mfulz/cyberpunk-elevated-district/images/README.md

# Image and video gallery

All publication media in this directory has been copied from the build archive,
resized where appropriate and stripped of EXIF metadata. The original files in
`screens/` remain untouched.

The collection is intentionally generous for the pre-publication review. Delete
any view that should not be public, then remove its link from this file and run
`python3 tools/update_checksums.py` followed by `python3 tools/verify_release.py`.

## Finished district

### Night views

Main night view

*Main release image: completed elevated district with the stair runner crossing
its red/purple phase.*

<table>
  <tr>
    <td>Blue night overview</td>
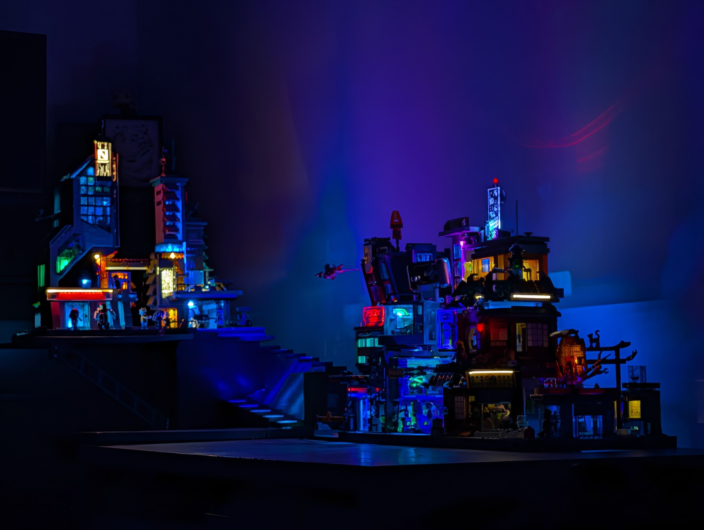
[picture p4: images/final/overview-night-cyan.jpg]
Cyan night overview
    <td></td>
  </tr>
  <tr>
    <td align="center"><em>Blue/purple phase</em></td>
    <td align="center"><em>Cyan/blue phase</em></td>
  </tr>
</table>

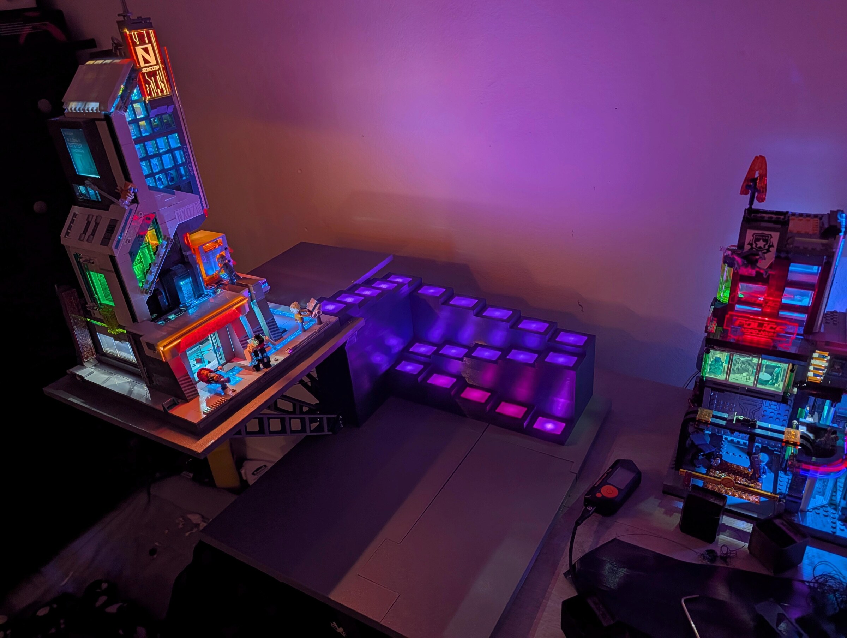
[picture p5: images/final/pre-techstation-night.jpg]
Earlier night arrangement before Tech Station


*Earlier night arrangement, useful for separating the printed structure from the
later fifth building.*

### Daylight and scale

<table>
  <tr>
    <td>Wide daylight overview</td>
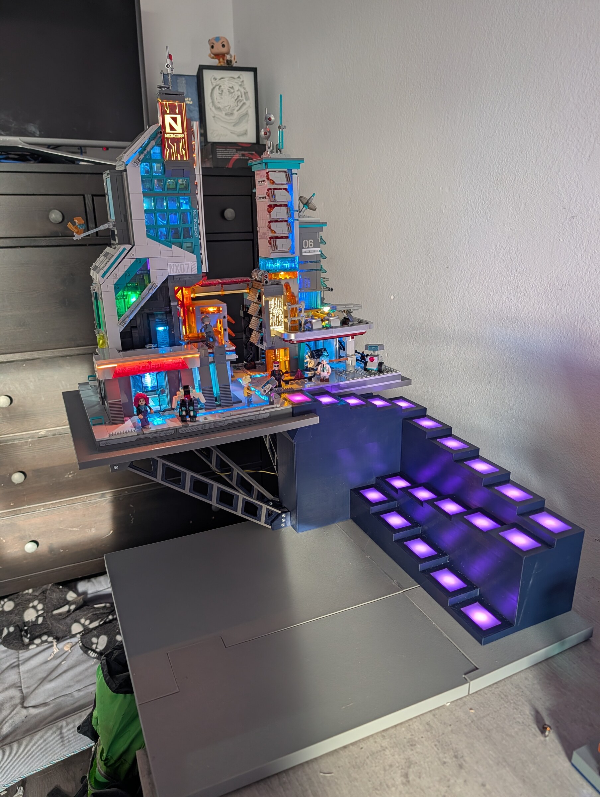
[picture p6: images/final/elevated-district-day.jpg]
Elevated district close daylight view
    <td></td>
  </tr>
  <tr>
    <td align="center"><em>Complete table and overhang</em></td>
    <td align="center"><em>Upper district, trusses and stairs</em></td>
  </tr>
  <tr>
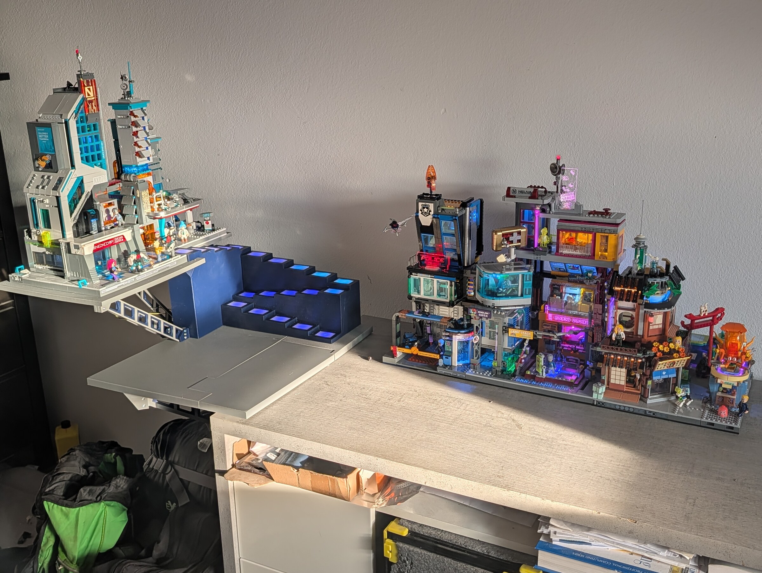
[picture p7: images/final/full-desk-day.jpg]
Full desk daylight view
    <td></td>
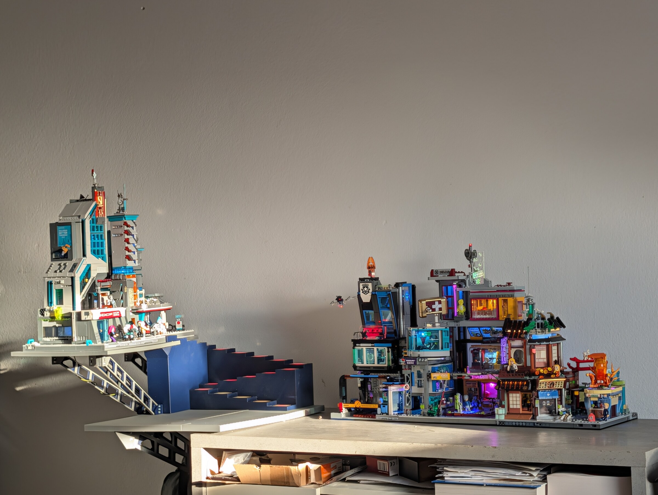
[picture p8: images/final/side-profile-day.jpg]
Side profile daylight view
    <td></td>
  </tr>
  <tr>
    <td align="center"><em>Normal room-scale view</em></td>
    <td align="center"><em>Side profile and visible cantilever</em></td>
  </tr>
</table>

## Construction sequence

### CAD and cable concept

<table>
  <tr>
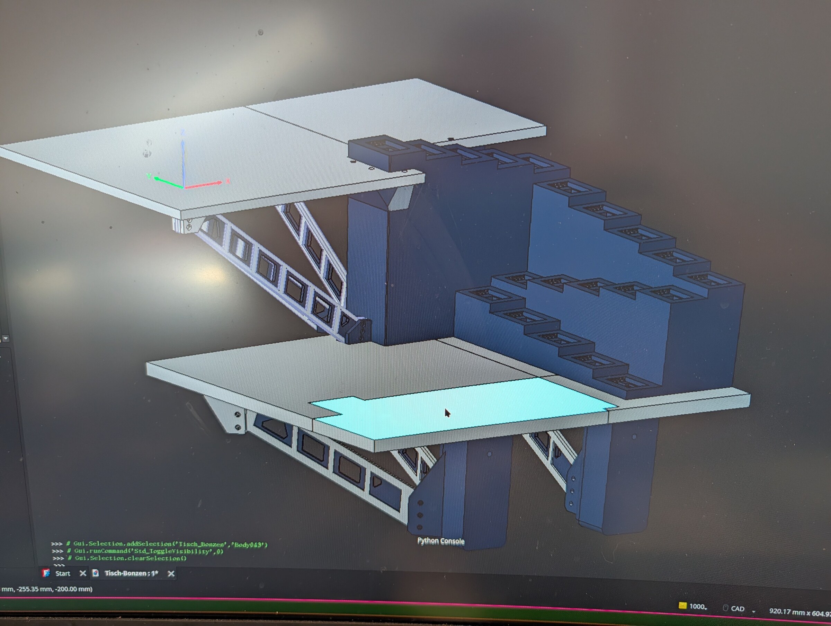
[picture p9: images/build/cad-complete.jpg]
Complete CAD structure
    <td></td>
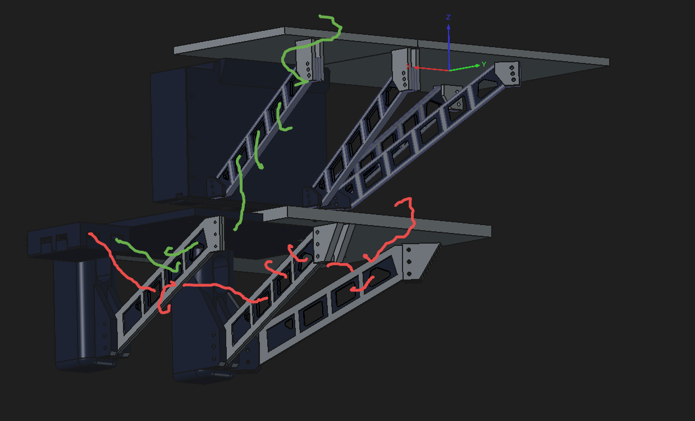
[picture p10: images/build/cad-cable-routing.png]
CAD cable-routing sketch
    <td></td>
  </tr>
  <tr>
    <td align="center"><em>Complete positioned structure</em></td>
    <td align="center"><em>Early exposed-cable routing concept</em></td>
  </tr>
</table>

### NeoPixel staircase development

<table>
  <tr>
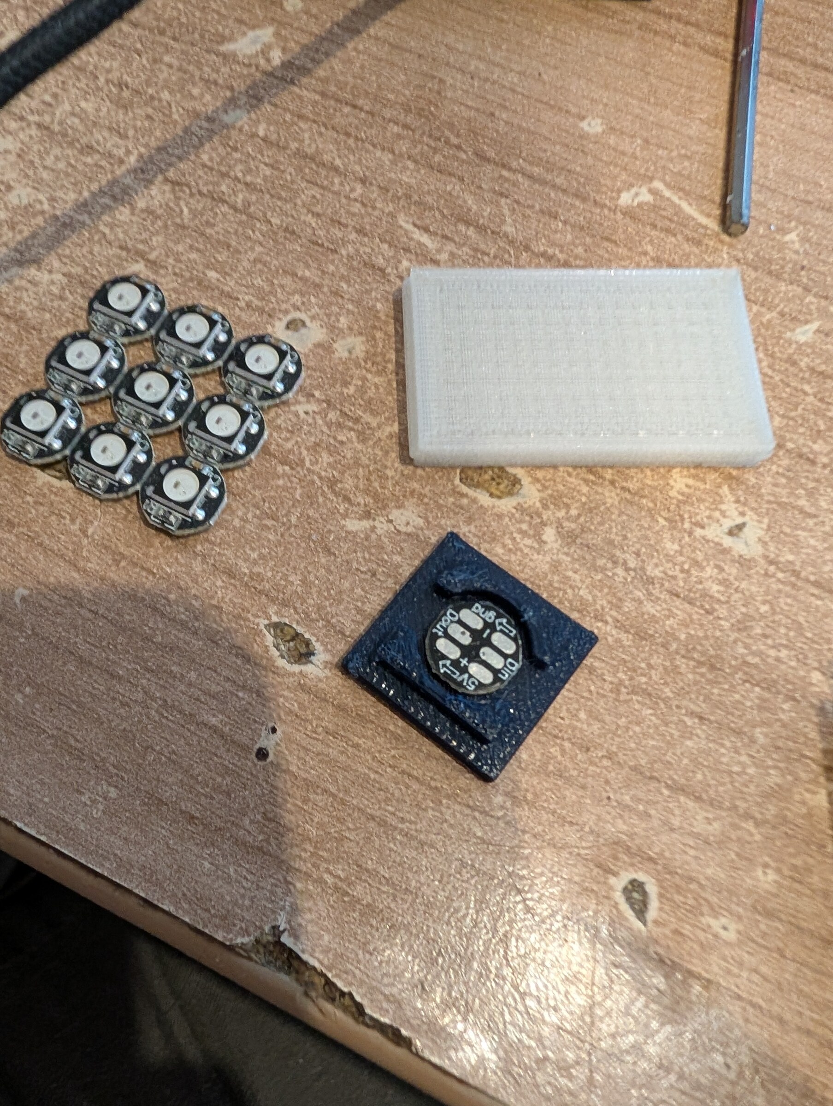
[picture p11: images/build/neopixel-diffuser-test.jpg]
NeoPixel carrier and diffuser test
    <td></td>
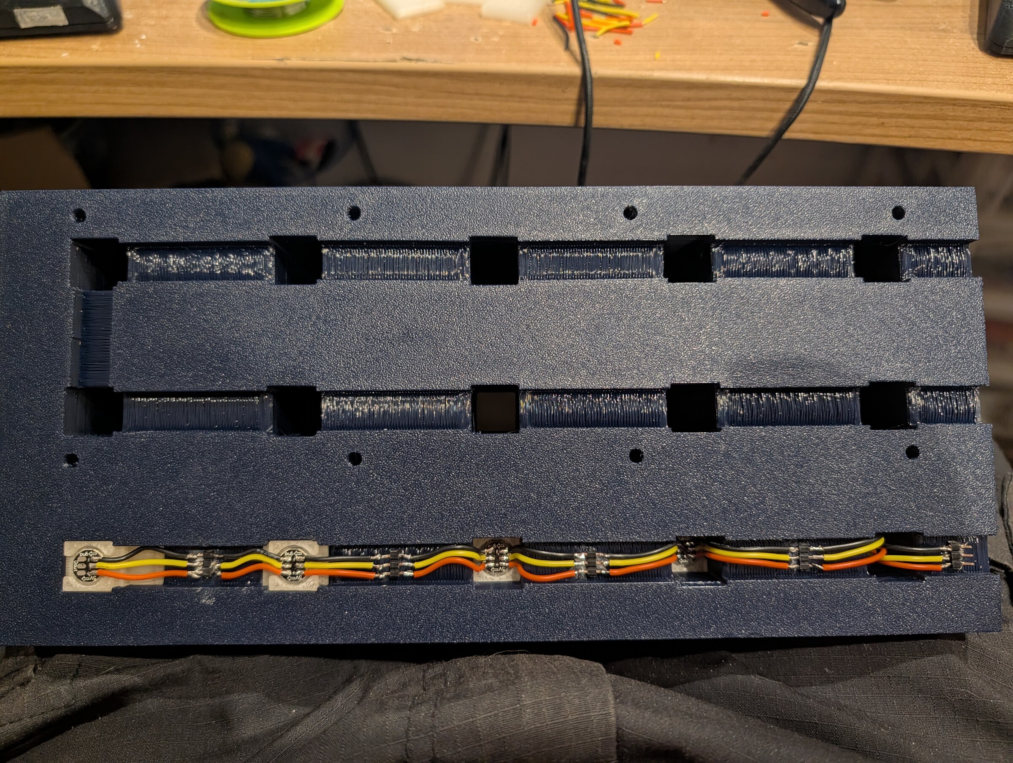
[picture p12: images/build/main-stair-led-chain.jpg]
Wired LED chain below the staircase
    <td></td>
  </tr>
  <tr>
    <td align="center"><em>Replaceable carrier and 100% infill diffuser test</em></td>
    <td align="center"><em>Five-pixel module wiring in its underside channel</em></td>
  </tr>
  <tr>
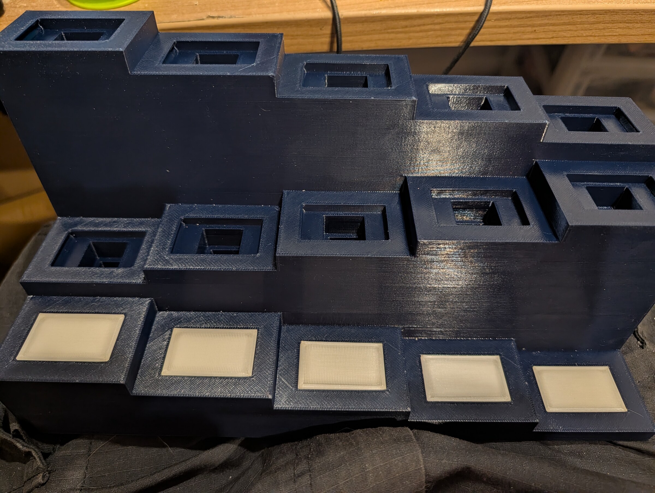
[picture p13: images/build/main-stair-assembled.jpg]
Assembled main staircase
    <td></td>
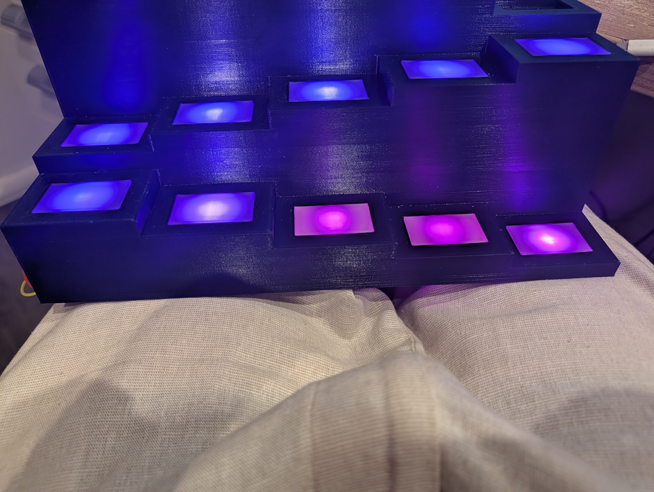
[picture p14: images/build/stair-light-test.jpg]
Illuminated staircase test
    <td></td>
  </tr>
  <tr>
    <td align="center"><em>Diffusers installed from above</em></td>
    <td align="center"><em>Ten-step animation and diffusion test</em></td>
  </tr>
</table>

### Controller and 5 V distribution

<table>
  <tr>
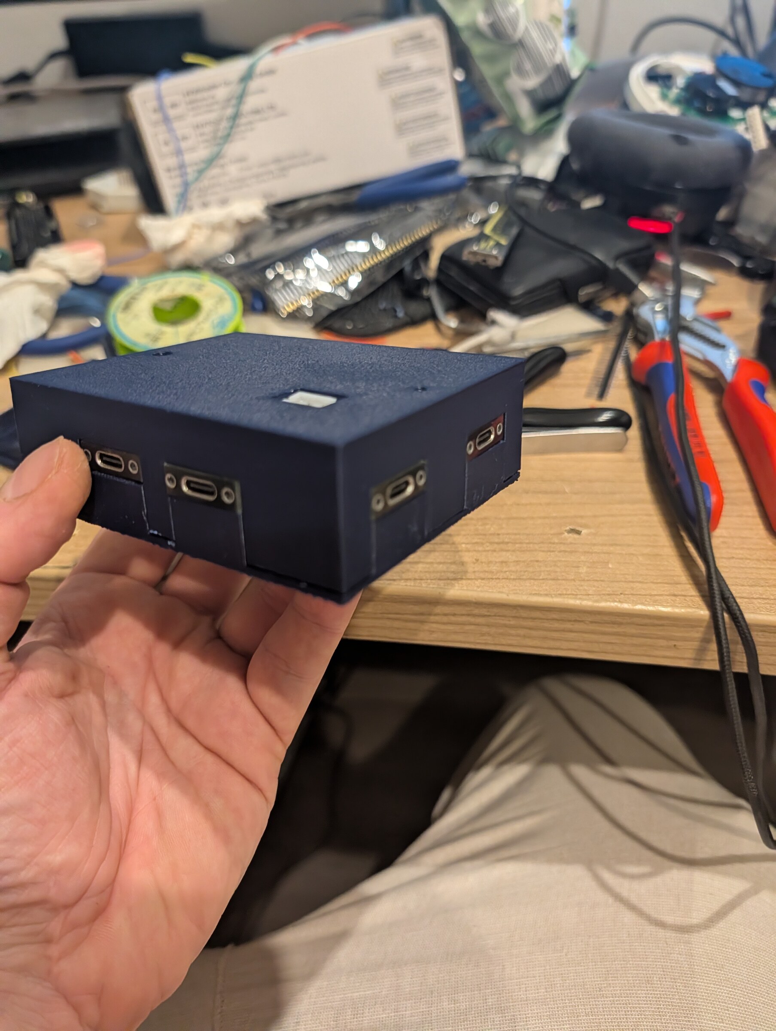
[picture p15: images/build/controller-enclosure-closed.jpg]
Closed controller enclosure
    <td></td>
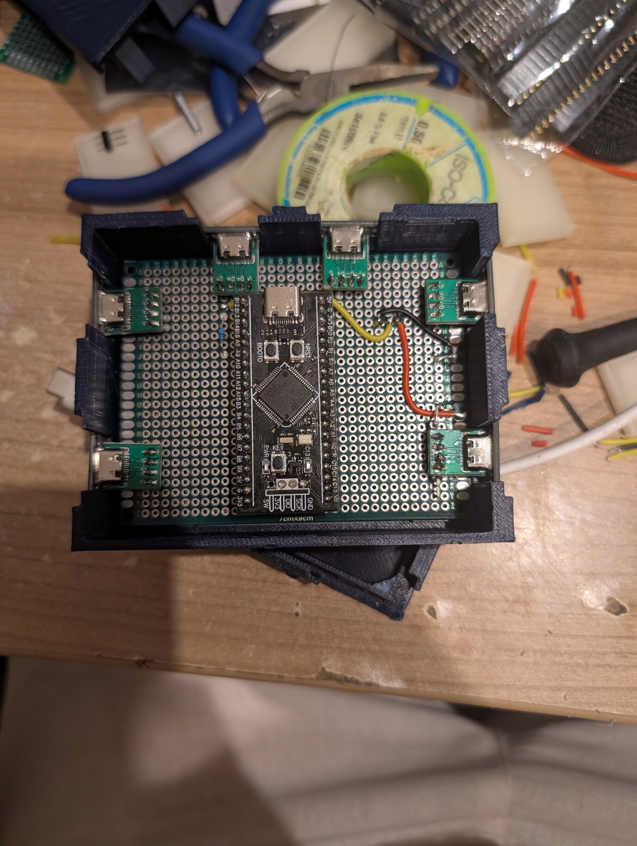
[picture p16: images/build/controller-enclosure-open-top.jpg]
Controller enclosure with open lid
    <td></td>
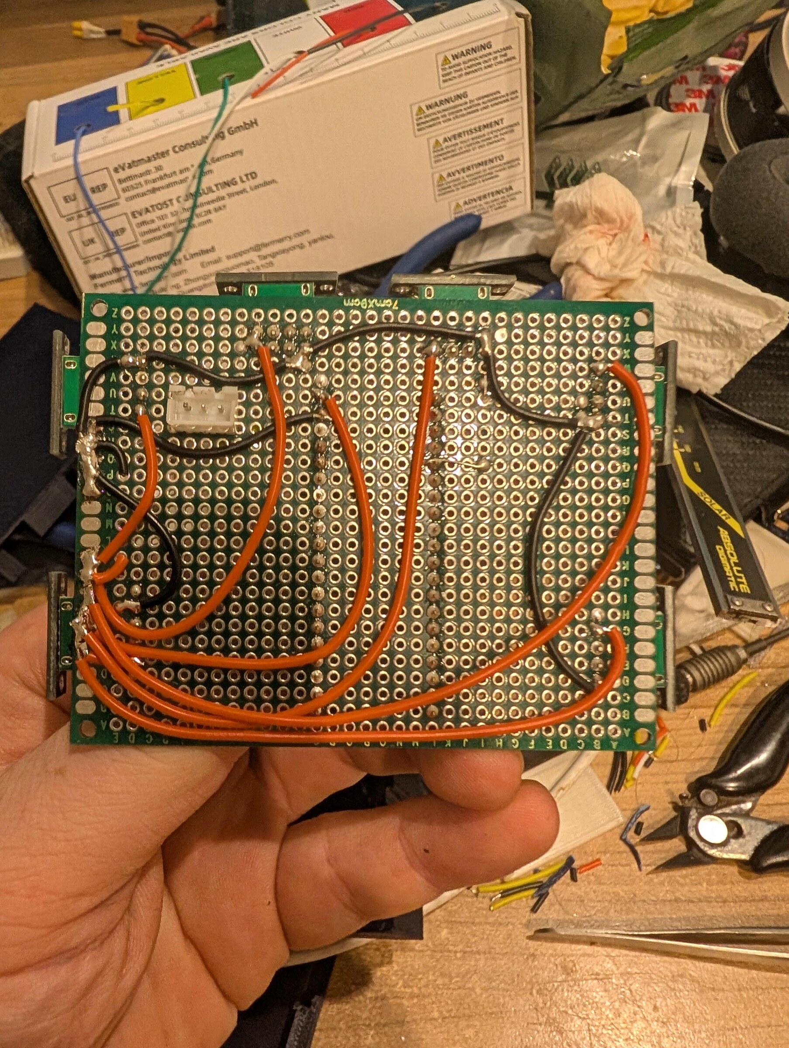
[picture p17: images/build/controller-perfboard-rear.jpg]
Rear of controller perfboard
    <td></td>
  </tr>
  <tr>
    <td align="center"><em>Five outputs plus one input</em></td>
    <td align="center"><em>BlackPill and reinforced star points</em></td>
    <td align="center"><em>Hand-wired perfboard underside</em></td>
  </tr>
</table>

### Structural assembly

<table>
  <tr>
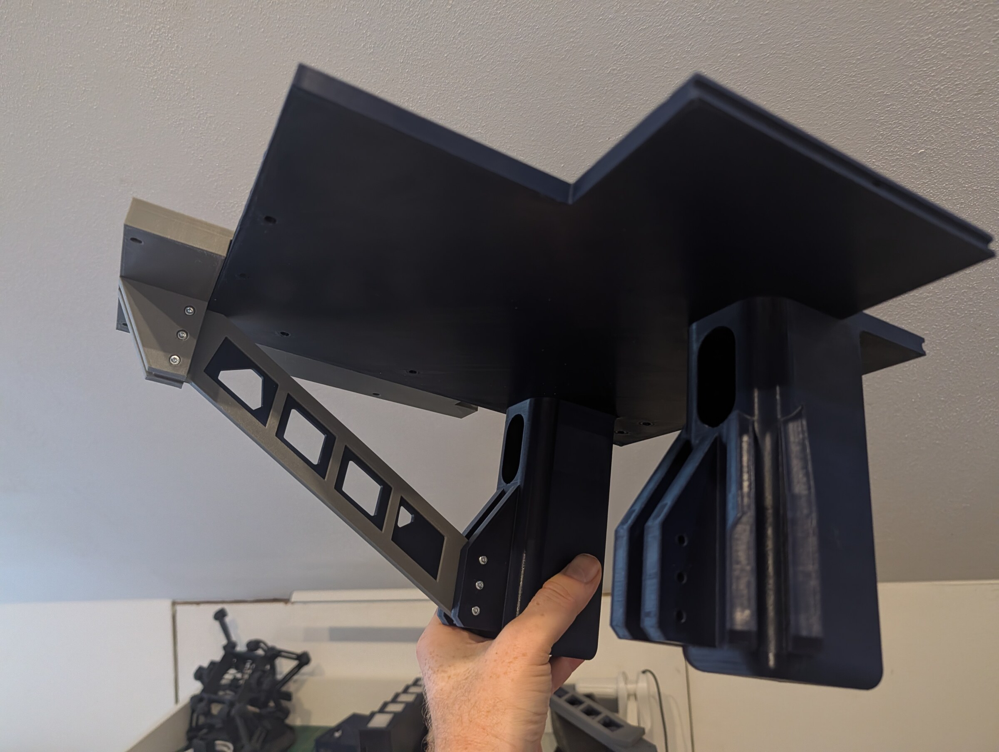
[picture p18: images/build/table-anchor-understructure.jpg]
Table anchor underside
    <td></td>
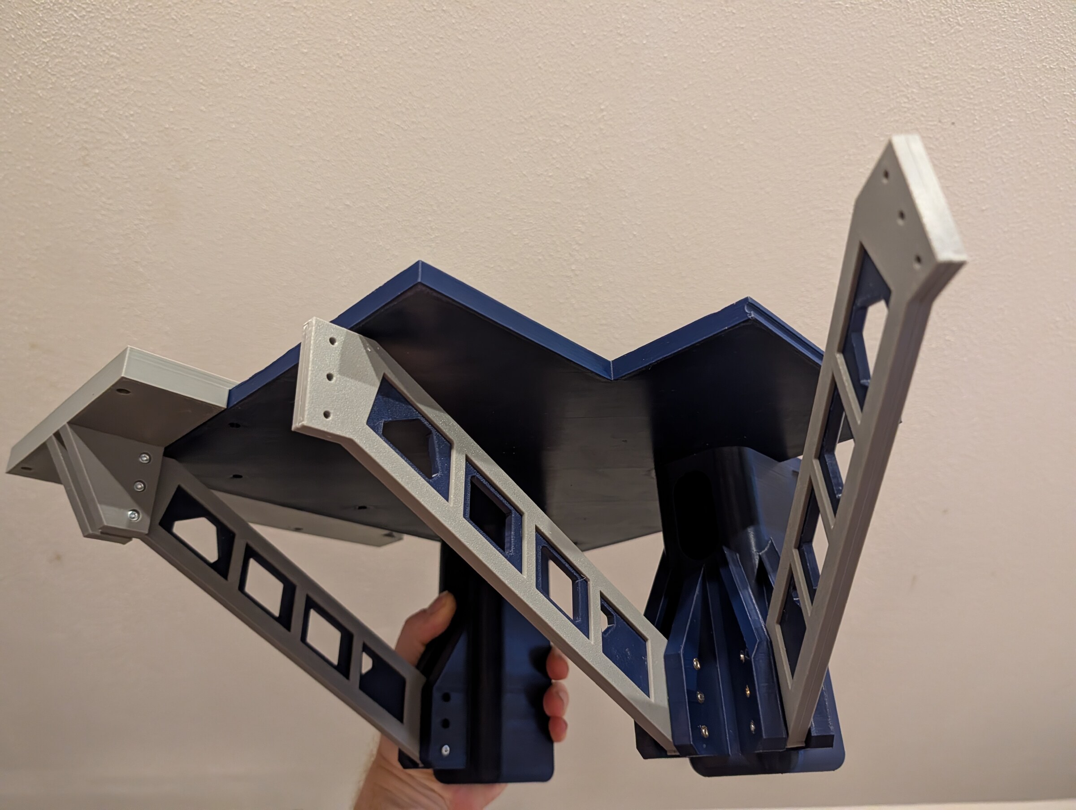
[picture p19: images/build/table-anchor-with-trusses.jpg]
Table anchor with laminated trusses
    <td></td>
  </tr>
  <tr>
    <td align="center"><em>Anchor, deck plates and interface blocks</em></td>
    <td align="center"><em>Laminated lower trusses before installation</em></td>
  </tr>
  <tr>
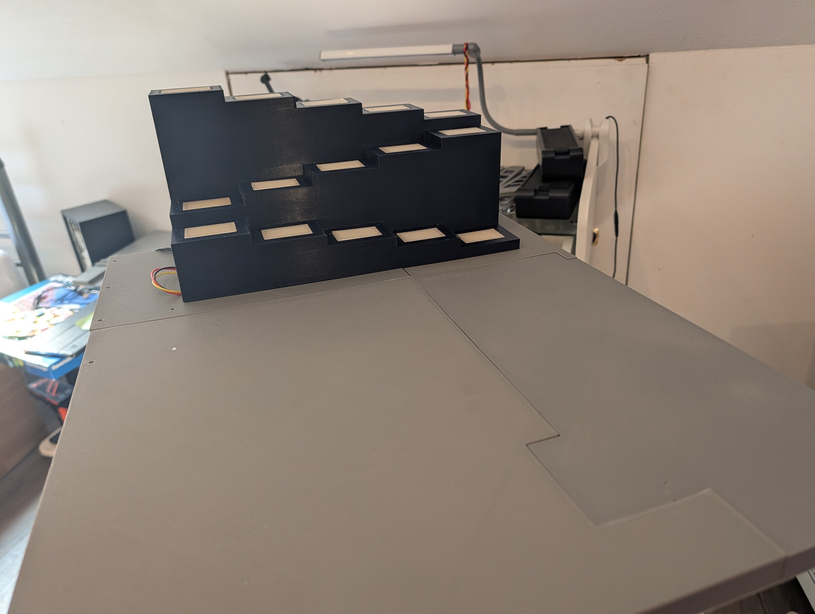
[picture p20: images/build/lower-deck-installed.jpg]
Lower deck installed on table
    <td></td>
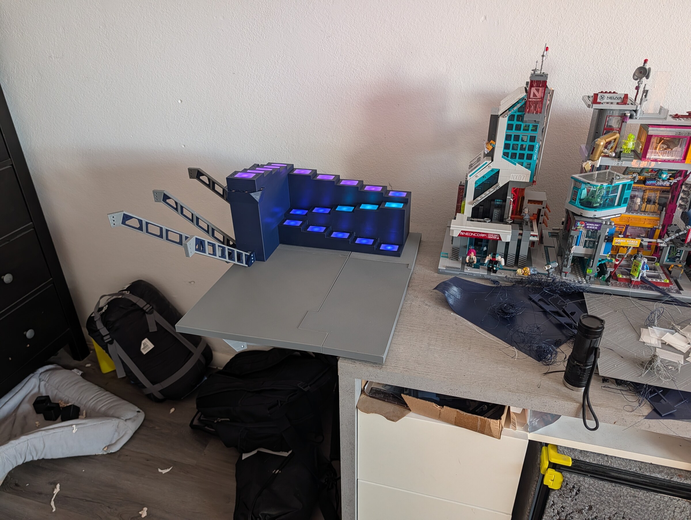
[picture p21: images/build/staircase-installation.jpg]
Staircase installation
    <td></td>
  </tr>
  <tr>
    <td align="center"><em>Lower deck and stair core mounted to the table</em></td>
    <td align="center"><em>Illuminated stair core before upper decks</em></td>
  </tr>
  <tr>
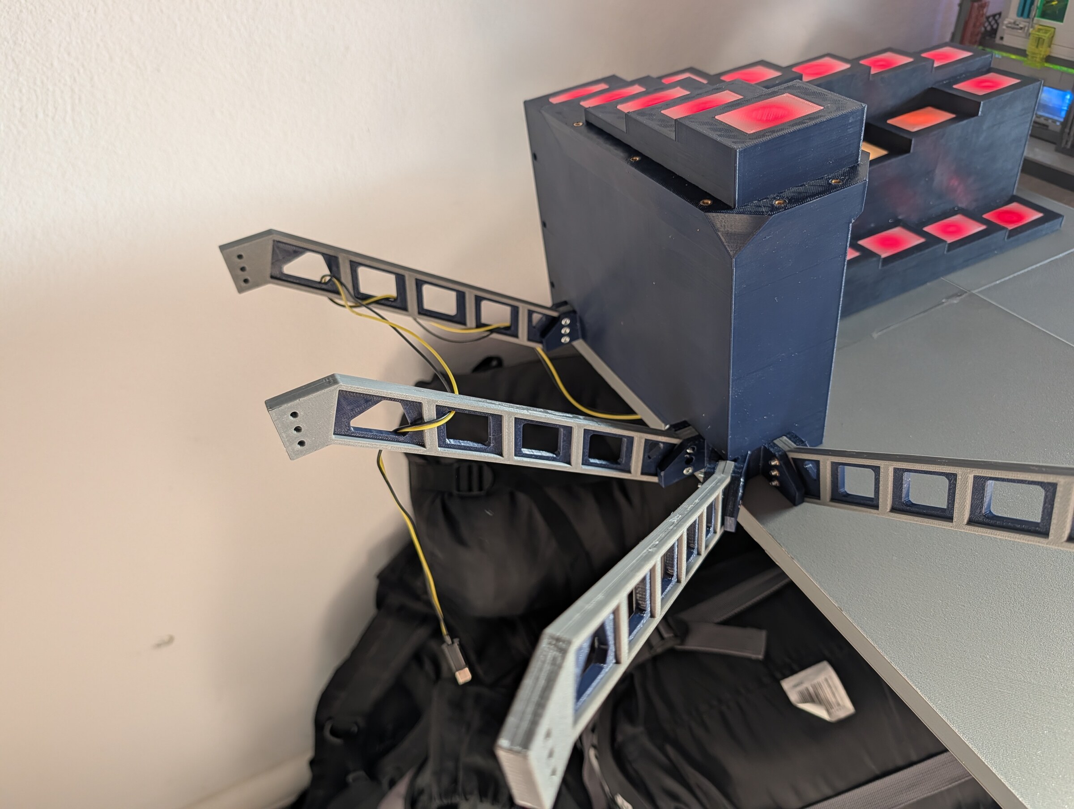
[picture p22: images/build/rear-cable-routing.jpg]
Rear cable routing
    <td></td>
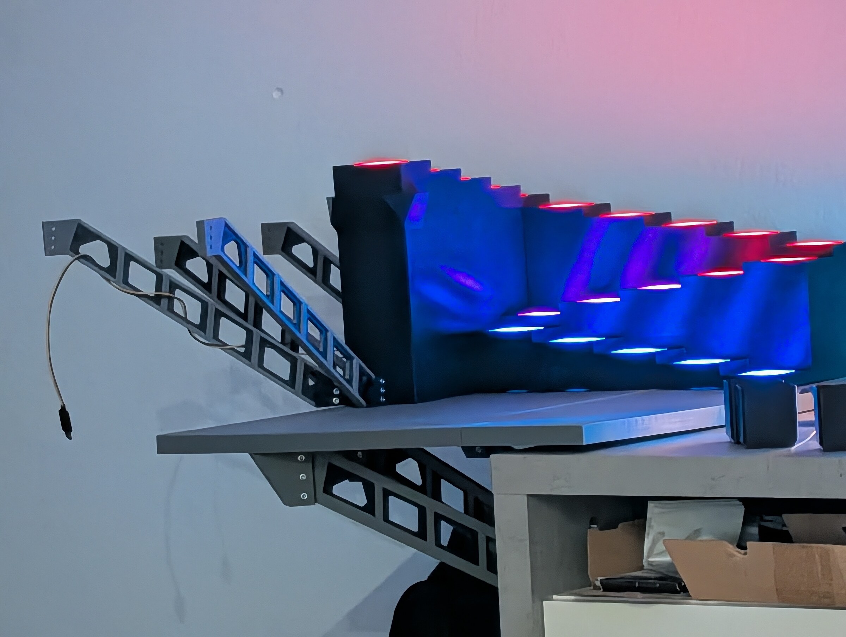
[picture p23: images/build/illuminated-structure.jpg]
Illuminated bare structure
    <td></td>
  </tr>
  <tr>
    <td align="center"><em>Rear joints and exposed building-power routing</em></td>
    <td align="center"><em>Bare structure under room lighting</em></td>
  </tr>
</table>

## Animation

[Download or play the 22-second H.264 staircase animation](video/stair-animation.mp4).
The publication copy is muted, has no retained metadata and uses a broadly
compatible H.264/yuv420p encoding.

## Source mapping

| Publication file | Original archive file |
|---|---|
| `final/hero-night.jpg` | `PXL_20261007_221115116.jpg` |
| `final/overview-night-blue.jpg` | `PXL_20261007_220911265.jpg` |
| `final/overview-night-cyan.jpg` | `PXL_20261007_220919024.jpg` |
| `final/overview-day.jpg` | `PXL_20261007_151711421.jpg` |
| `final/elevated-district-day.jpg` | `PXL_20261007_151716509.jpg` |
| `final/full-desk-day.jpg` | `PXL_20261007_152434728.jpg` |
| `final/side-profile-day.jpg` | `PXL_20261007_152644959.jpg` |
| `final/pre-techstation-night.jpg` | `PXL_20261007_005833567.jpg` |
| `build/cad-complete.jpg` | manually selected replacement CAD overview |
| `build/cad-cable-routing.png` | `2026-09-29_00-46-26.png` |
| `build/neopixel-diffuser-test.jpg` | `PXL_20260925_084540838.jpg` |
| `build/main-stair-assembled.jpg` | `PXL_20260927_211636154.jpg` |
| `build/main-stair-led-chain.jpg` | `PXL_20260927_211629722.jpg` |
| `build/stair-light-test.jpg` | `PXL_20260929_004639660.jpg` |
| `build/controller-enclosure-closed.jpg` | `PXL_20260928_213608950.jpg` |
| `build/controller-enclosure-open-top.jpg` | `PXL_20260928_214320691.jpg` |
| `build/controller-perfboard-rear.jpg` | `PXL_20260928_214328911.jpg` |
| `build/table-anchor-understructure.jpg` | `PXL_20261002_144736083.jpg` |
| `build/table-anchor-with-trusses.jpg` | `PXL_20261002_231009219.jpg` |
| `build/lower-deck-installed.jpg` | `PXL_20261005_101639394.jpg` |
| `build/staircase-installation.jpg` | `PXL_20261006_112620395.jpg` |
| `build/rear-cable-routing.jpg` | `PXL_20261006_145401554.jpg` |
| `build/illuminated-structure.jpg` | `PXL_20261006_181119379.jpg` |
| `video/stair-animation.mp4` | `PXL_20261007_203457445.mp4` |
