mfulz/cyberpunk-elevated-district/models/print/step/main-staircase-15-step.step

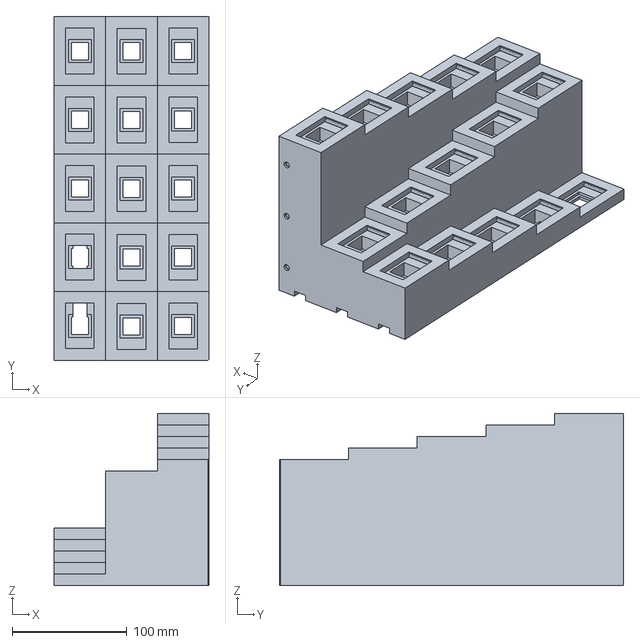
[picture p24: CAD file, 2026-10-08]
models/print/step/main-staircase-15-step.step
135.0 x 300.0 x 150.0 mm
