mfulz/cyberpunk-elevated-district/models/print/step/lower-truss-front-shell.step

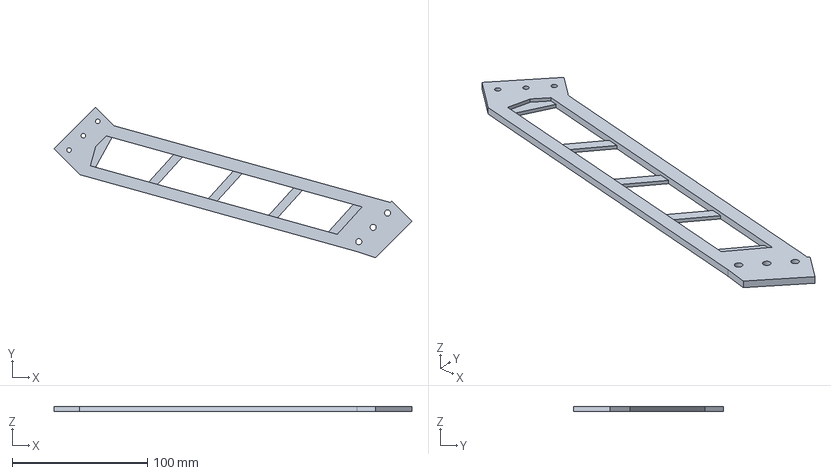
[picture p25: CAD file, 2026-10-08]
models/print/step/lower-truss-front-shell.step
264.5 x 111.1 x 4.00 mm
