mfulz/cyberpunk-elevated-district/models/source/FreeCAD/lumibricks-cyberpunk-mega-structure.FCStd

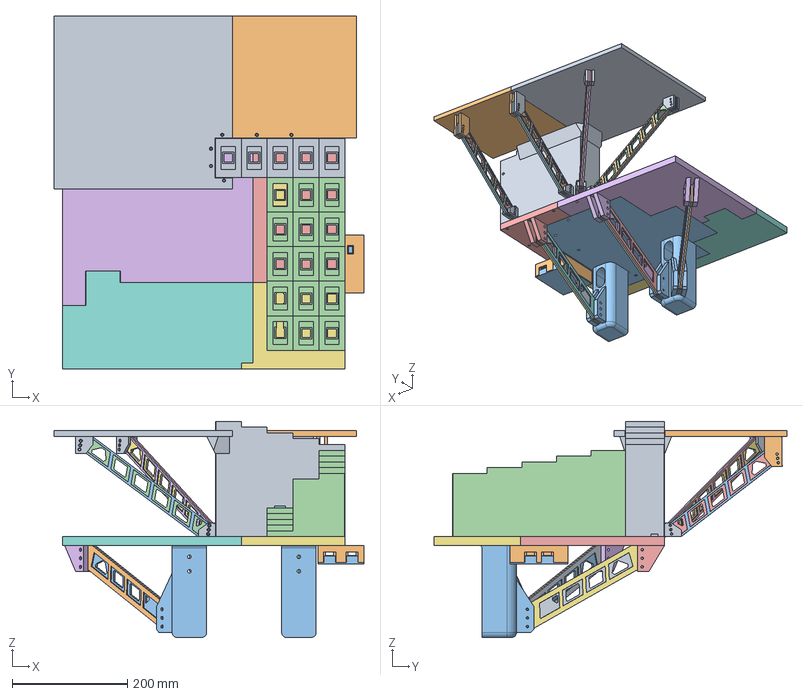
[picture p26: CAD file, 2026-10-08]
models/source/FreeCAD/lumibricks-cyberpunk-mega-structure.FCStd
538.0 x 612.0 x 375.0 mm
Upper Platform - Large
Upper Platform - Small
Table Anchor Frame
Main Staircase - 15-Step Module
Lower Deck Plate 01
Lower Deck Plate 02
Lower Deck Plate 03
Lower Deck Plate 04
Lower Truss 01 - Rear Shell
Lower Truss 01 - Front Shell
Lower Truss 01 - Inlay
Lower Truss 02 - Rear Shell
Lower Truss 02 - Front Shell
Lower Truss 02 - Inlay
Lower Truss 03 - Rear Shell
Lower Truss 03 - Front Shell
Lower Truss 03 - Inlay
Upper Truss 01 - Rear Shell
Upper Truss 01 - Front Shell
Upper Truss 01 - Inlay
Upper Truss 02 - Rear Shell
Upper Truss 02 - Front Shell
Upper Truss 02 - Inlay
Upper Truss 03 - Rear Shell
Upper Truss 03 - Front Shell
Upper Truss 03 - Inlay
Upper Truss 04 - Rear Shell
Upper Truss 04 - Front Shell
Upper Truss 04 - Inlay
NeoPixel Stair Light - LED Carrier
NeoPixel Stair Light - Diffuser
NeoPixel Stair Light - Spacer
Upper Staircase - 5-Step Module
Electronics Enclosure - Base
Electronics Enclosure - Lid
