mfulz/cyberpunk-elevated-district/models/source/STEP/upper-stair-neopixel-carrier-adapter-source.step

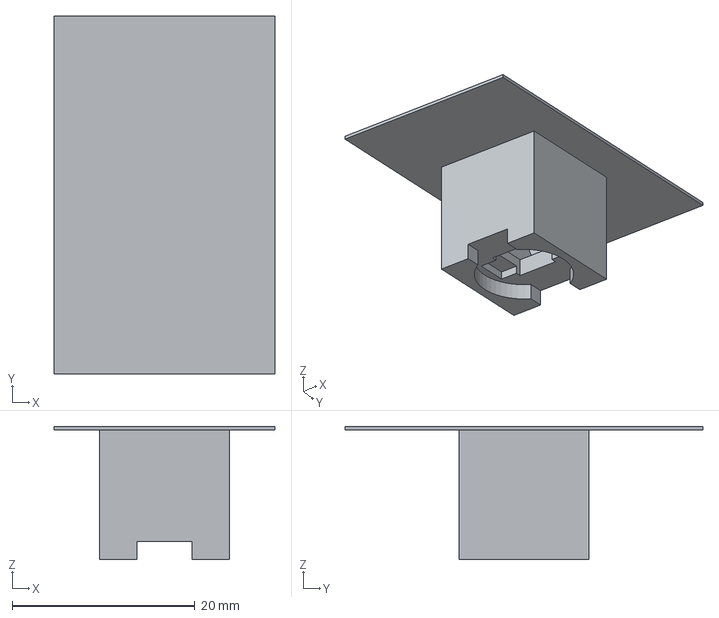
[picture p27: CAD file, 2026-10-08]
models/source/STEP/upper-stair-neopixel-carrier-adapter-source.step
24.2 x 39.2 x 14.6 mm
