mfulz/cyberpunk-elevated-district/models/print/step/electronics-enclosure-lid.step

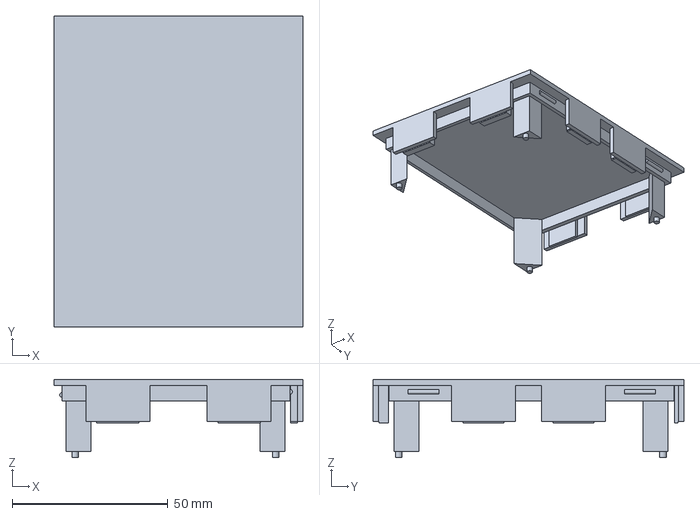
[picture p28: CAD file, 2026-10-08]
models/print/step/electronics-enclosure-lid.step
80.0 x 100.0 x 25.2 mm
