mfulz/cyberpunk-elevated-district/models/source/STEP/upper-stair-neopixel-diffuser-source.step

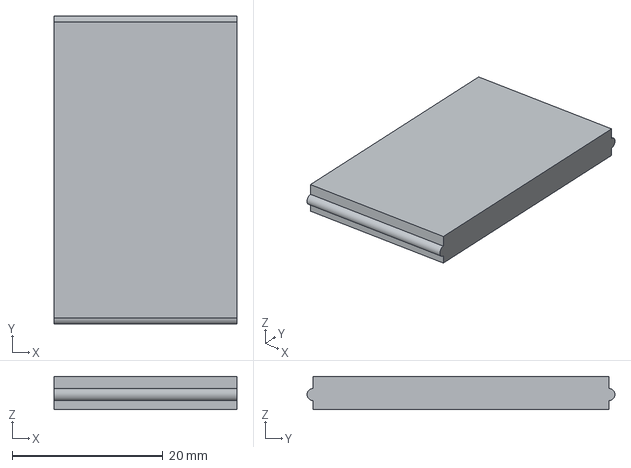
[picture p29: CAD file, 2026-10-08]
models/source/STEP/upper-stair-neopixel-diffuser-source.step
24.2 x 40.8 x 4.40 mm
