mfulz/cyberpunk-elevated-district/models/print/step/lower-deck-plate-03.step

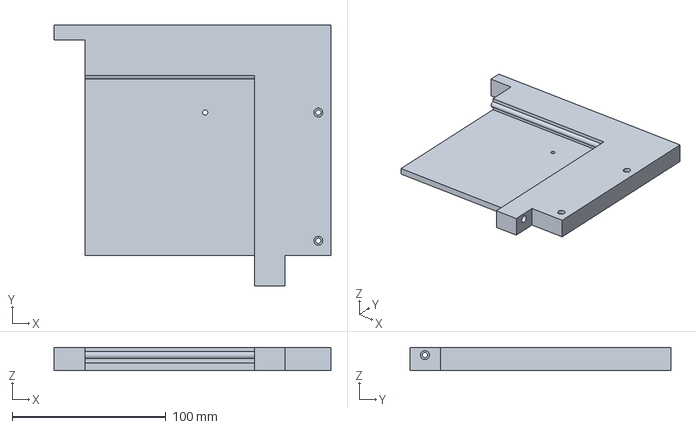
[picture p30: CAD file, 2026-10-08]
models/print/step/lower-deck-plate-03.step
180.0 x 169.8 x 15.0 mm
