mfulz/cyberpunk-elevated-district/models/print/step/lower-deck-plate-04.step

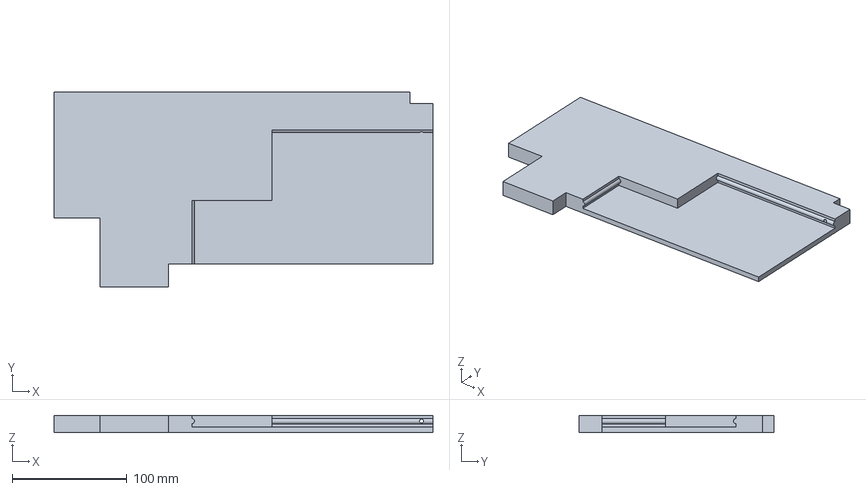
[picture p31: CAD file, 2026-10-08]
models/print/step/lower-deck-plate-04.step
330.0 x 169.8 x 15.0 mm
