mfulz/cyberpunk-elevated-district/models/print/step/upper-platform-small.step

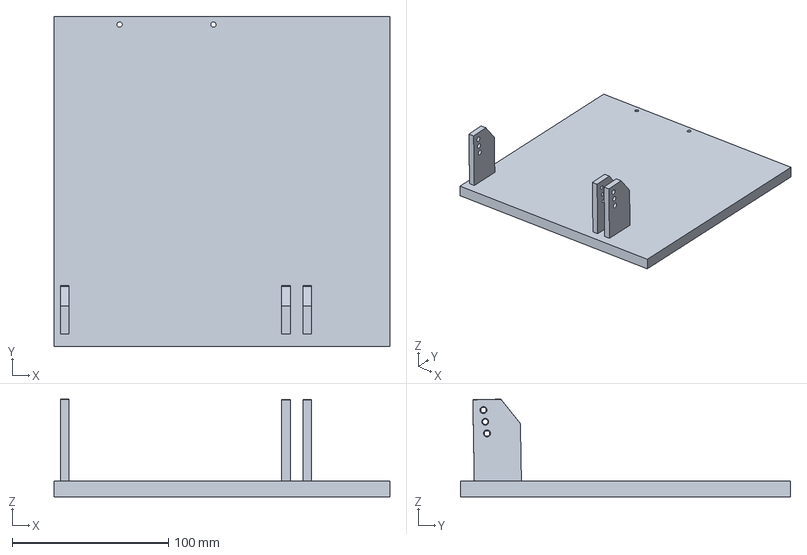
[picture p32: CAD file, 2026-10-08]
models/print/step/upper-platform-small.step
215.0 x 211.2 x 62.5 mm
