mfulz/cyberpunk-elevated-district/models/print/step/neopixel-standard-spacer.step

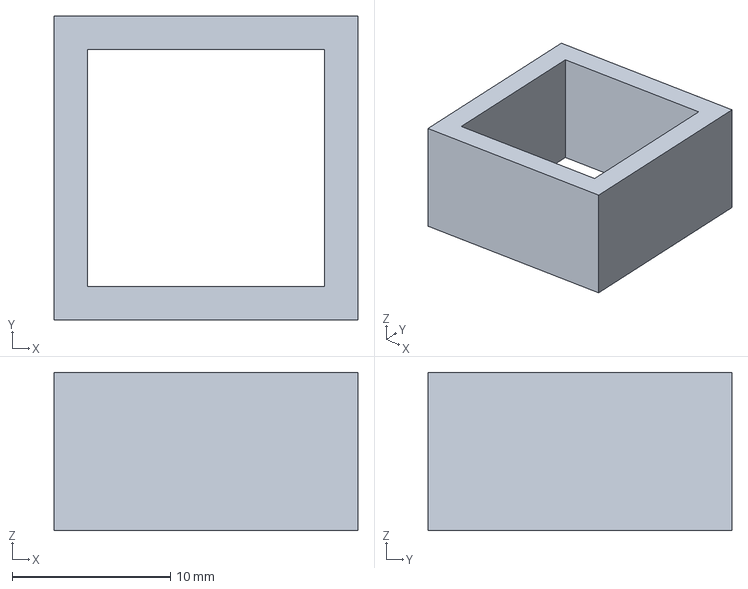
[picture p33: CAD file, 2026-10-08]
models/print/step/neopixel-standard-spacer.step
19.2 x 19.2 x 10.0 mm
