mfulz/cyberpunk-elevated-district/models/print/step/electronics-enclosure-base.step

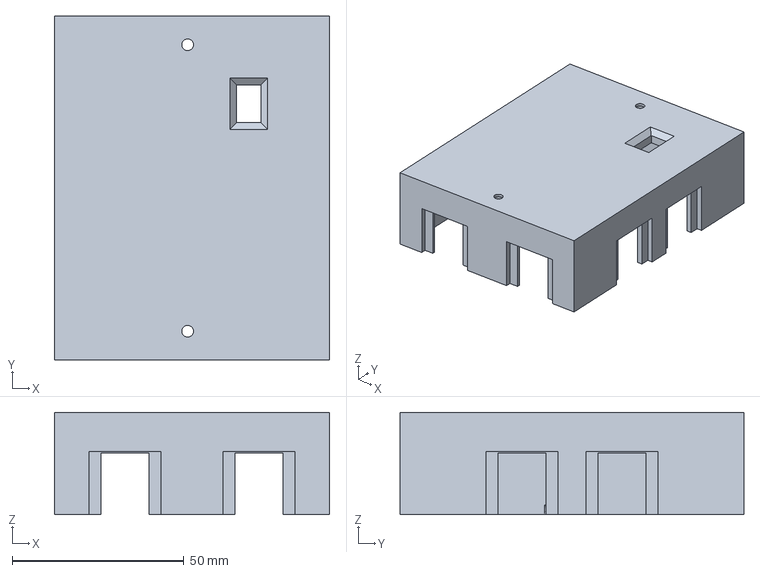
[picture p34: CAD file, 2026-10-08]
models/print/step/electronics-enclosure-base.step
80.0 x 100.0 x 29.8 mm
