mfulz/cyberpunk-elevated-district/models/print/step/neopixel-standard-carrier.step

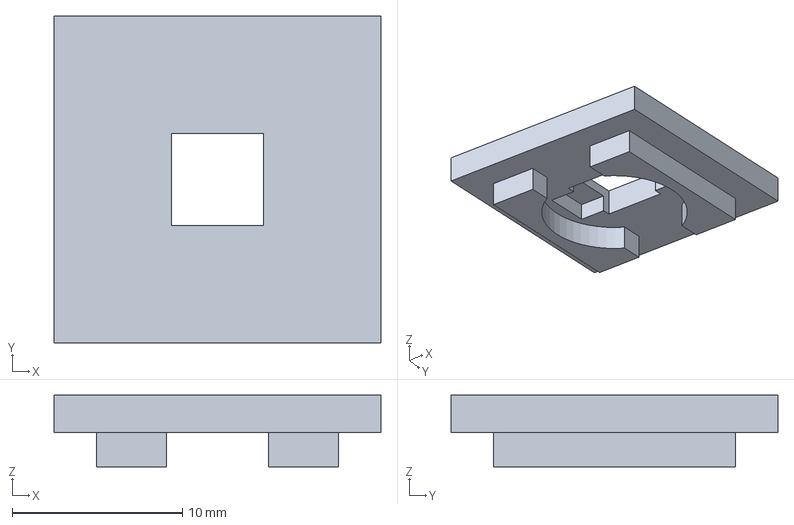
[picture p35: CAD file, 2026-10-08]
models/print/step/neopixel-standard-carrier.step
19.2 x 19.2 x 4.20 mm
