mfulz/cyberpunk-elevated-district/models/print/step/upper-truss-long-inlay.step

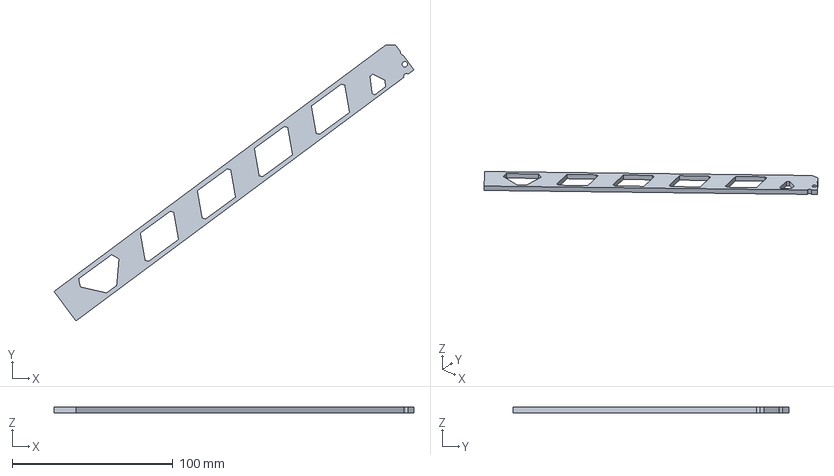
[picture p36: CAD file, 2026-10-08]
models/print/step/upper-truss-long-inlay.step
224.3 x 171.9 x 4.00 mm
