mfulz/cyberpunk-elevated-district/models/print/step/table-anchor-frame.step

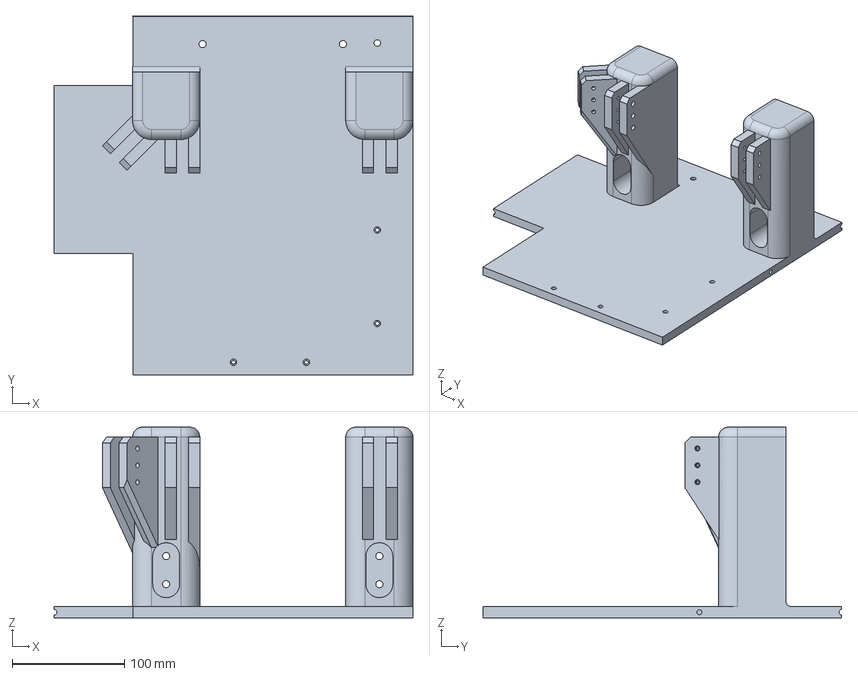
[picture p37: CAD file, 2026-10-08]
models/print/step/table-anchor-frame.step
320.0 x 319.8 x 170.0 mm
