mfulz/cyberpunk-elevated-district/models/print/step/lower-truss-inlay.step

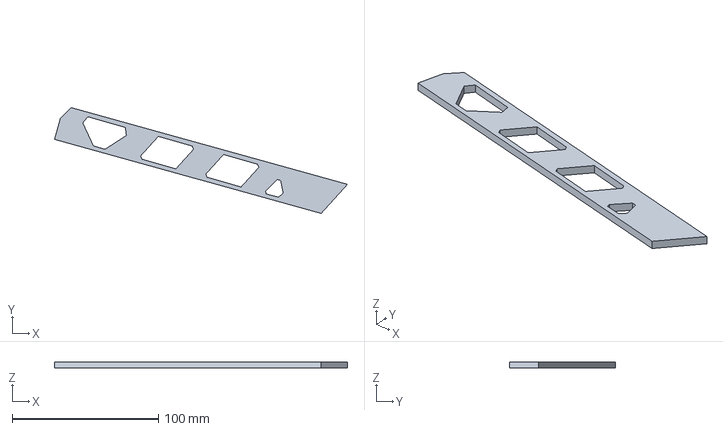
[picture p38: CAD file, 2026-10-08]
models/print/step/lower-truss-inlay.step
200.3 x 72.3 x 4.00 mm
