mfulz/cyberpunk-elevated-district/models/print/step/upper-truss-short-inlay.step

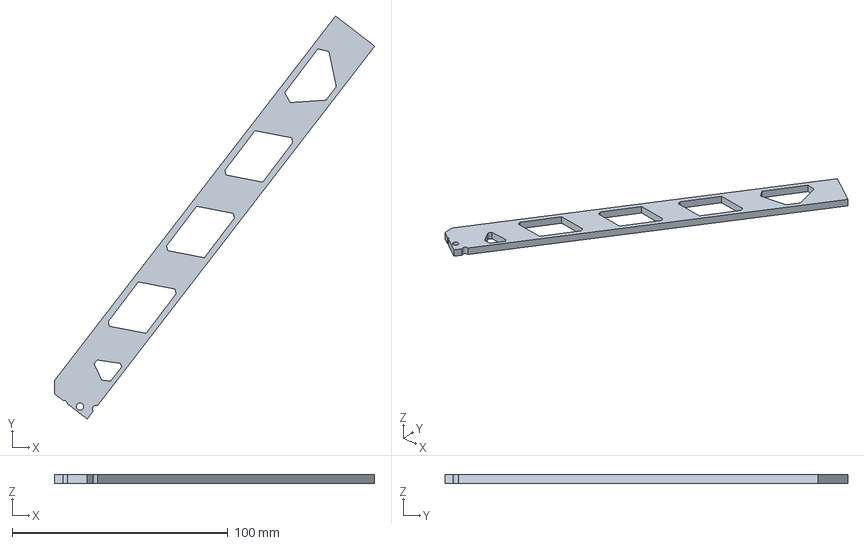
[picture p39: CAD file, 2026-10-08]
models/print/step/upper-truss-short-inlay.step
148.5 x 186.7 x 4.00 mm
