mfulz/cyberpunk-elevated-district/models/print/step/neopixel-standard-diffuser.step

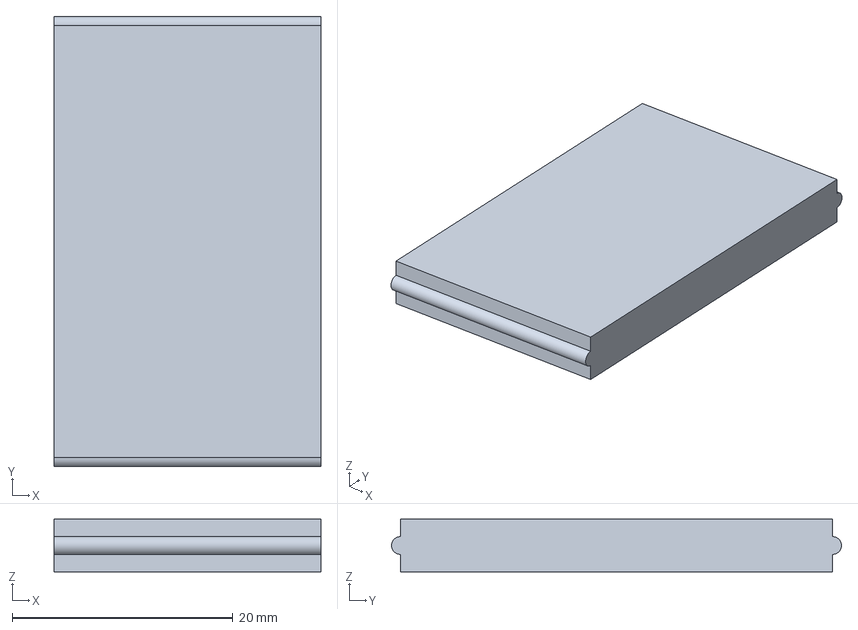
[picture p40: CAD file, 2026-10-08]
models/print/step/neopixel-standard-diffuser.step
24.2 x 40.8 x 4.80 mm
