mfulz/cyberpunk-elevated-district/models/print/step/upper-staircase-5-step.step

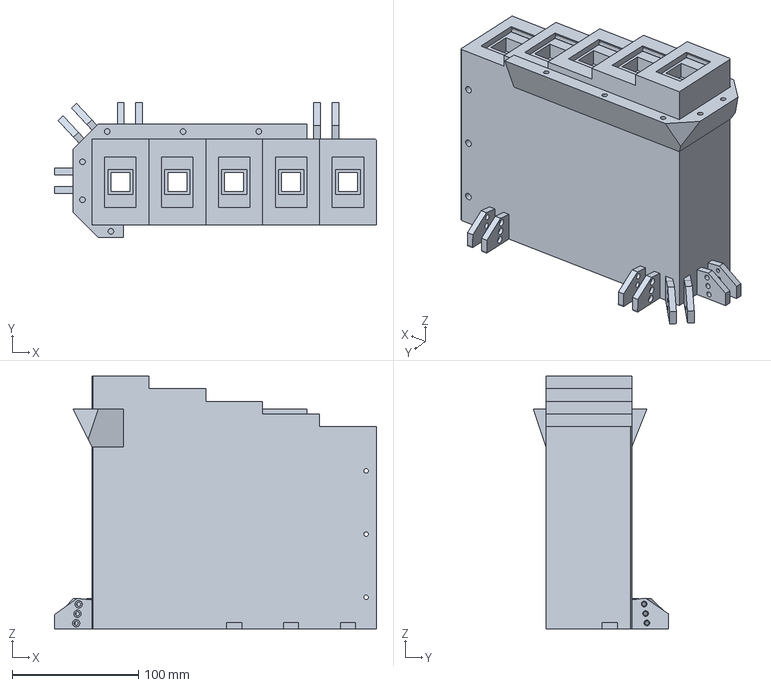
[picture p41: CAD file, 2026-10-08]
models/print/step/upper-staircase-5-step.step
254.6 x 107.1 x 200.0 mm
