mfulz/cyberpunk-elevated-district/models/print/step/upper-truss-long-shell.step

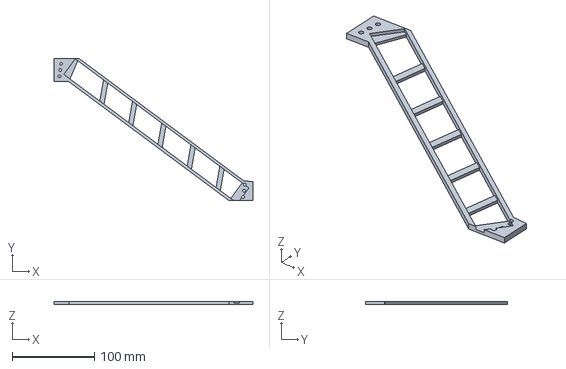
[picture p42: CAD file, 2026-10-08]
models/print/step/upper-truss-long-shell.step
241.8 x 172.9 x 4.00 mm
