mfulz/cyberpunk-elevated-district/models/print/step/upper-platform-large.step

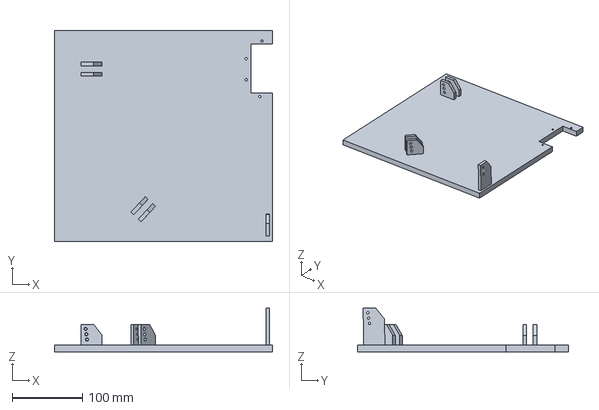
[picture p43: CAD file, 2026-10-08]
models/print/step/upper-platform-large.step
310.0 x 300.0 x 62.5 mm
