mfulz/cyberpunk-elevated-district/models/print/step/lower-deck-plate-02.step

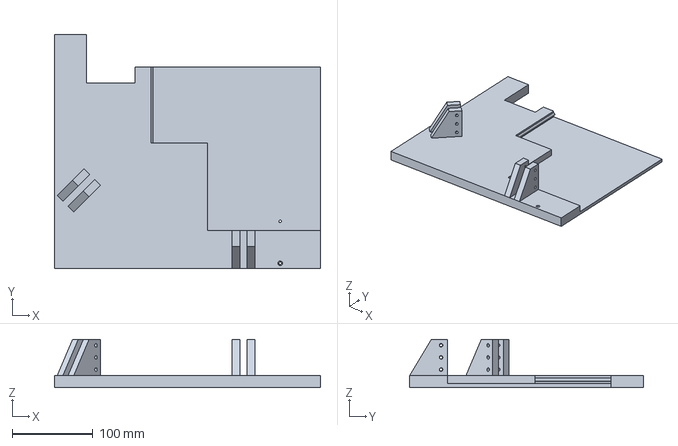
[picture p44: CAD file, 2026-10-08]
models/print/step/lower-deck-plate-02.step
330.0 x 290.0 x 60.0 mm
