mfulz/cyberpunk-elevated-district/models/print/step/lower-deck-plate-01.step

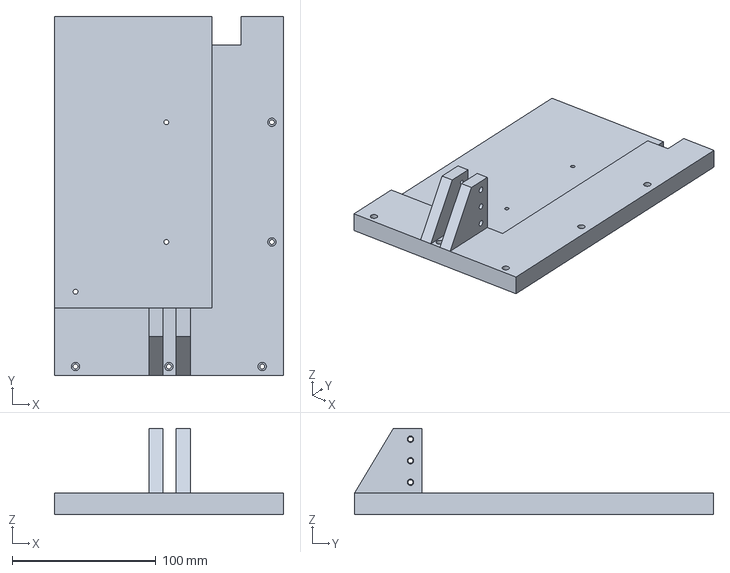
[picture p45: CAD file, 2026-10-08]
models/print/step/lower-deck-plate-01.step
159.8 x 250.0 x 60.0 mm
