mfulz/cyberpunk-elevated-district/models/print/step/upper-truss-short-shell.step

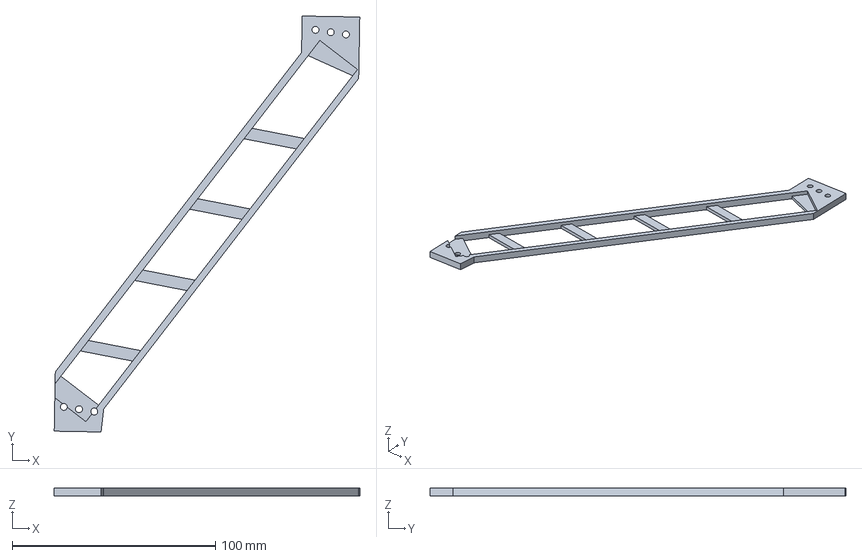
[picture p46: CAD file, 2026-10-08]
models/print/step/upper-truss-short-shell.step
150.2 x 204.5 x 4.00 mm
