mfulz/cyberpunk-elevated-district/(list of files, cad)

Other CAD files:
models/print/step/lower-truss-rear-shell.step
models/print/step/upper-stair-neopixel-carrier-adapter.step
models/print/step/upper-stair-neopixel-diffuser.step
models/print/stl/electronics-enclosure-base.stl
models/print/stl/electronics-enclosure-lid.stl
models/print/stl/lower-deck-plate-01.stl
models/print/stl/lower-deck-plate-02.stl
models/print/stl/lower-deck-plate-03.stl
models/print/stl/lower-deck-plate-04.stl
models/print/stl/lower-truss-front-shell.stl
models/print/stl/lower-truss-inlay.stl
models/print/stl/lower-truss-rear-shell.stl
models/print/stl/main-staircase-15-step.stl
models/print/stl/neopixel-standard-carrier.stl
models/print/stl/neopixel-standard-diffuser.stl
models/print/stl/neopixel-standard-spacer.stl
models/print/stl/table-anchor-frame.stl
models/print/stl/upper-platform-large.stl
models/print/stl/upper-platform-small.stl
models/print/stl/upper-stair-neopixel-carrier-adapter.stl
models/print/stl/upper-stair-neopixel-diffuser.stl
models/print/stl/upper-staircase-5-step.stl
models/print/stl/upper-truss-long-inlay.stl
models/print/stl/upper-truss-long-shell.stl
models/print/stl/upper-truss-short-inlay.stl
models/print/stl/upper-truss-short-shell.stl
